rbenamotz/LEMPA/imgs/2D_V4.png

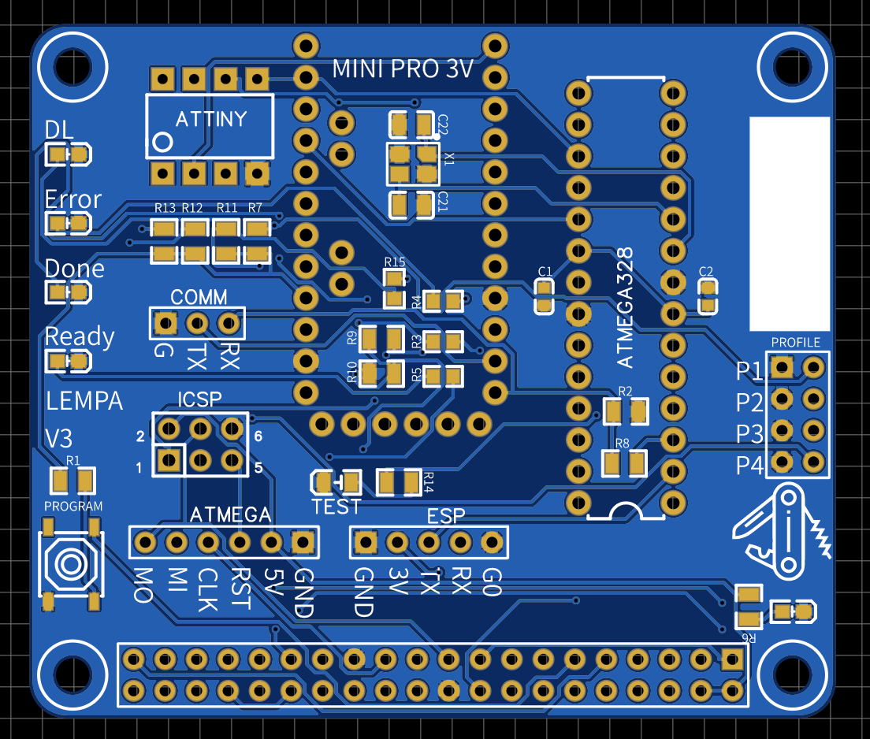
imgs/2D_V4.png
