rbenamotz/LEMPA/imgs/3D.png

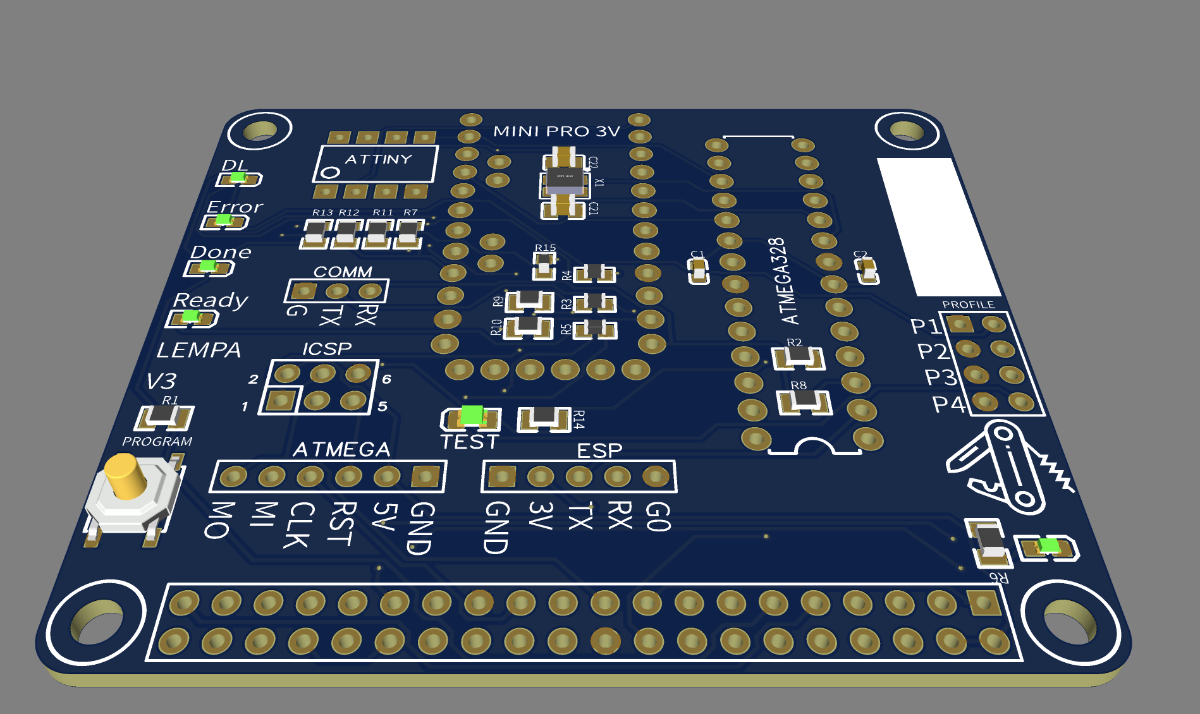
imgs/3D.png
