rbenamotz/LEMPA/imgs/arduino ide.png

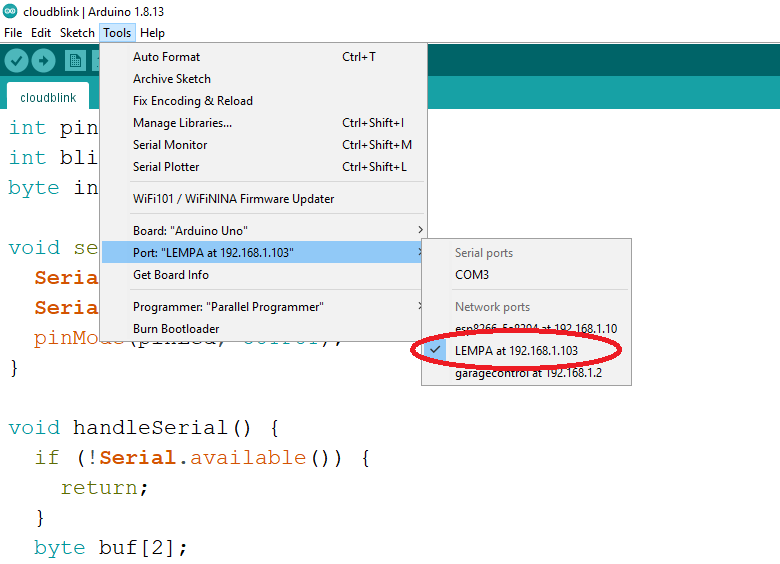
imgs/arduino ide.png
