rbenamotz/LEMPA/imgs/v41_2d.jpg

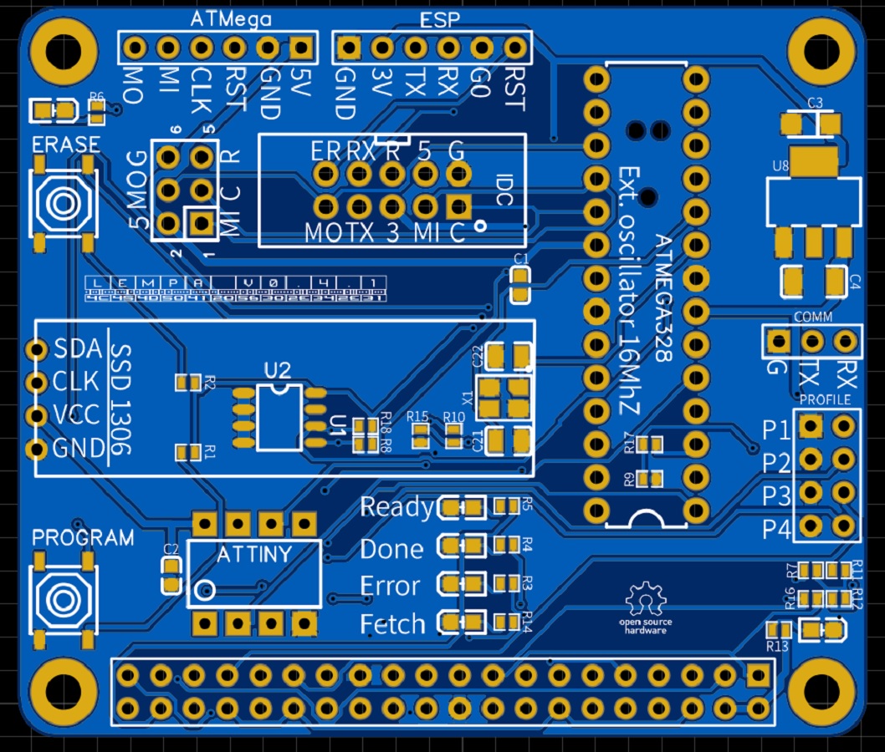
imgs/v41_2d.jpg
