rbenamotz/LEMPA/imgs/v41_4.jpg

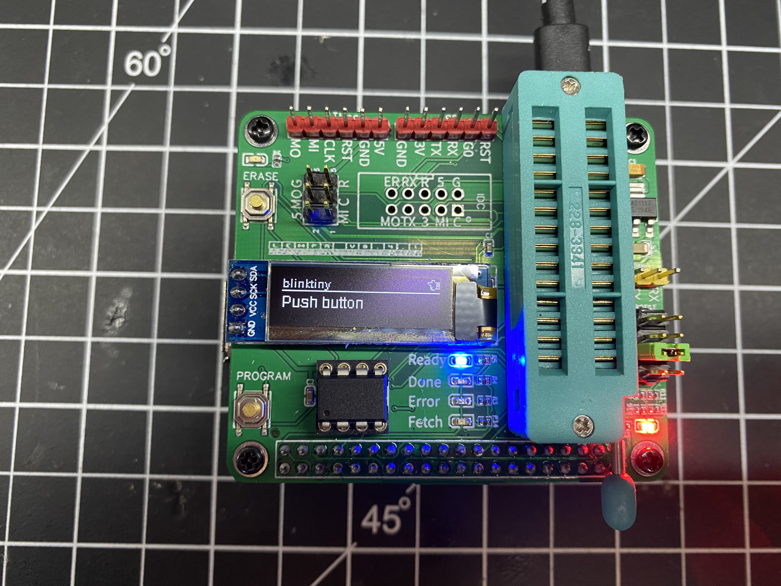
imgs/v41_4.jpg
