rbenamotz/LEMPA/imgs/v41_schematic.jpg

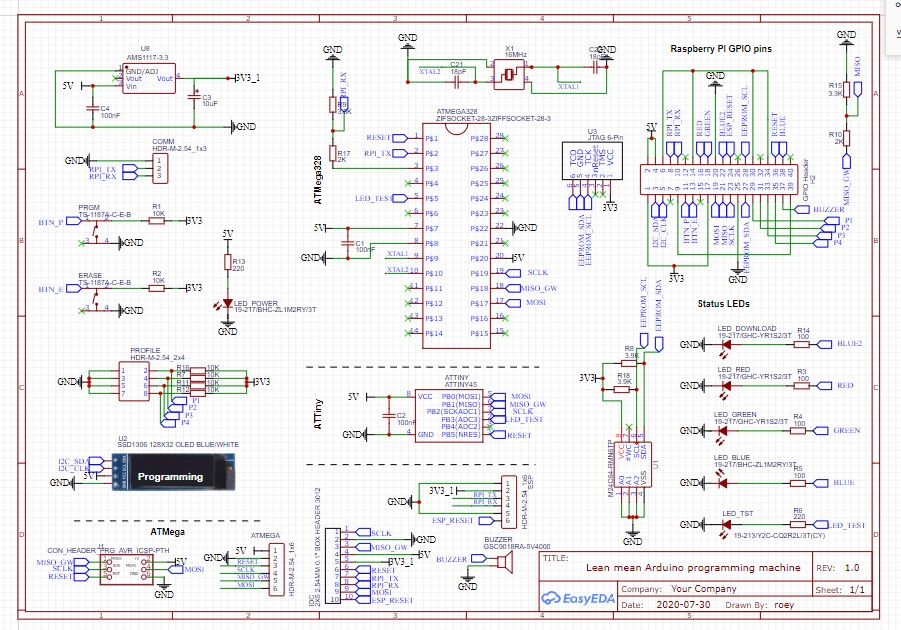
imgs/v41_schematic.jpg
