rbenamotz/LEMPA/imgs/yt.png

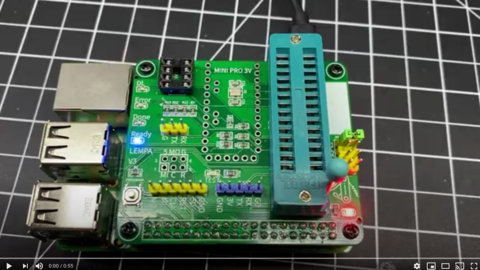
imgs/yt.png
