rbenamotz/LEMPA/(threads)

Thread 2 (2020-09-06):

Feature request: support for TI Spyi-Bi-Wire

codehero, 2020-09-06:
This would be useful for programming single or multiple MSP430 units.

rbenamotz, 2020-09-06:
I don't have access to such a board at the moment but will keep that as future issue. Thanks!

codehero, 2020-09-07:
I will order you an MSP430 launchpad if you want. The way the jumpers work you can select between the onboard programmer and your RPI gpio. I am sure the mspdebug folks would be happy to help out.

rbenamotz, 2020-09-07:
Can you contact me at roey@benamotz.com ?

Thread 3 (2020-09-06):

PCB Schematic?

mtfurlan, 2020-09-06:
I can't seem to find the actual schematic for the PCB?

I've been working on a kinda similar thing, designed around a USB<-->UART FT232 instead of a pi, and I'm curious how you're dealing with GPIO0 and 3V3 on the ESP to rest it properly and such things.
I've been planning to use the reset circuit off the D1 mini, but I'm curious as to how you approached it.

rbenamotz, 2020-09-06:
Hi

You can find the schematics here:

https://easyeda.com/roey/flower-tzarvan_copy

I am taking a very simple approach toward ESP (but it works): One of the pins is for GPIO0 and it's always grounded so once you connect the ESP, it's on program mode. Once programming is done you unplug the ESP.
On future version I am adding option for reset.

Another issue I approacheed with ESP was the fact that in many boards I have ATMega32 + ESP on the same board connected via serial. When that happens I cannot program the ESP as the ATMega keeps the TX pin HIGH all the time. The solution I used is the following:
1. I created a very small ATMega firmware which just disables the TX `(_SFR_BYTE(UCSRB) &= ~_BV(TXEN));`
2. Added a script capbility to the programmer (composite in the JSON)
3. The programmer, on single click, does the follwing: 1. Load the dummy firmware to ATMega 2. Loads the ESP (as its serial is free now) 3. Loads the real firmware to the ATMega

Hope this helps

Roey

mtfurlan, 2020-09-06:
Oh, that makes sense.
Thank you!

Closed 2020-09-06.

Thread 10 (2020-10-04):

Button won't response if down before state loads

rbenamotz, 2020-10-04:
**Describe the bug**
Button won't response if down before state loads

**To Reproduce**
Steps to reproduce the behavior:
1. Push prog button
2. Start LEMPA (don't let go of the button)
3. Release the button only when it enters the "wait for button" state

**Expected behavior**
Clicking on a prog button will.. prog but it does not respond

rbenamotz, 2020-10-04:
fixed (and anyway it was created to test the github comments mechanism)

Closed 2020-10-04.

Thread 20 (2020-10-30):

Remote I/O error

rbenamotz, 2020-10-30:
[Errno 121] Remote I/O error
Traceback (most recent call last):
  File "./program.py", line 54, in <module>
    cycle()
  File "./program.py", line 41, in cycle
    event = state.do_step()
  File "/home/pi/LEMPA/states/wait_for_button_state.py", line 39, in do_step
    if self.button_erase.loop() or self.button_prog.loop():
  File "/home/pi/LEMPA/states/hat_button.py", line 68, in loop
    return self.__check_long_click()
  File "/home/pi/LEMPA/states/hat_button.py", line 43, in __check_long_click
    self.app.print(self.long_click_action_name + "? " + str(pt))
  File "/home/pi/LEMPA/application.py", line 58, in print
    v.print(txt)
  File "/home/pi/LEMPA/views/display_view.py", line 88, in print
    self.__refresh()
  File "/home/pi/LEMPA/views/display_view.py", line 78, in __refresh
    self.disp.display()
  File "/home/pi/.local/lib/python3.7/site-packages/Adafruit_SSD1306/SSD1306.py", line 182, in display
    self._i2c.writeList(control, self._buffer[i:i+16])
  File "/home/pi/.local/lib/python3.7/site-packages/Adafruit_GPIO/I2C.py", line 127, in writeList
    self._bus.write_i2c_block_data(self._address, register, data)
  File "/home/pi/.local/lib/python3.7/site-packages/Adafruit_PureIO/smbus.py", line 364, in write_i2c_block_data
    self._device.write(data)
OSError: [Errno 121] Remote I/O error

                              Exception
Traceback (most recent call last):
  File "./program.py", line 54, in <module>
    cycle()
  File "./program.py", line 41, in cycle
    event = state.do_step()
  File "/home/pi/LEMPA/states/wait_for_button_state.py", line 39, in do_step
    if self.button_erase.loop() or self.button_prog.loop():
  File "/home/pi/LEMPA/states/hat_button.py", line 68, in loop
    return self.__check_long_click()
  File "/home/pi/LEMPA/states/hat_button.py", line 43, in __check_long_click
    self.app.print(self.long_click_action_name + "? " + str(pt))
  File "/home/pi/LEMPA/application.py", line 58, in print
    v.print(txt)
  File "/home/pi/LEMPA/views/display_view.py", line 88, in print
    self.__refresh()
  File "/home/pi/LEMPA/views/display_view.py", line 78, in __refresh
    self.disp.display()
  File "/home/pi/.local/lib/python3.7/site-packages/Adafruit_SSD1306/SSD1306.py", line 182, in display
    self._i2c.writeList(control, self._buffer[i:i+16])
  File "/home/pi/.local/lib/python3.7/site-packages/Adafruit_GPIO/I2C.py", line 127, in writeList
    self._bus.write_i2c_block_data(self._address, register, data)
  File "/home/pi/.local/lib/python3.7/site-packages/Adafruit_PureIO/smbus.py", line 364, in write_i2c_block_data
    self._device.write(data)
OSError: [Errno 121] Remote I/O error

During handling of the above exception, another exception occurred:

Traceback (most recent call last):
  File "./program.py", line 62, in <module>
    state = load_state(Application.APP_STATE_EXCEPTION)
  File "./program.py", line 31, in load_state
    app.app_state = code
  File "/home/pi/LEMPA/application.py", line 92, in app_state
    v.header()
  File "/home/pi/LEMPA/views/display_view.py", line 98, in header
    self.__refresh()
  File "/home/pi/LEMPA/views/display_view.py", line 78, in __refresh
    self.disp.display()
  File "/home/pi/.local/lib/python3.7/site-packages/Adafruit_SSD1306/SSD1306.py", line 168, in display
    self.command(0)              # Column start address. (0 = reset)
  File "/home/pi/.local/lib/python3.7/site-packages/Adafruit_SSD1306/SSD1306.py", line 129, in command
    self._i2c.write8(control, c)
  File "/home/pi/.local/lib/python3.7/site-packages/Adafruit_GPIO/I2C.py", line 114, in write8
    self._bus.write_byte_data(self._address, register, value)
  File "/home/pi/.local/lib/python3.7/site-packages/Adafruit_PureIO/smbus.py", line 322, in write_byte_data
    self._device.write(data)
OSError: [Errno 121] Remote I/O error

Closed 2021-03-13.
