rbenamotz/LEMPA/hardware.py

# buttons
PIN_BUTTON_PROG = 17
PIN_BUTTON_ERASE = 27

# LEDs
PIN_RED = 23
PIN_GREEN = 24
PIN_BLUE = 20
PIN_BLUE2 = 25

# Jumpers
PINS_PROFILES = [5, 6, 13, 19]

# MCU
PIN_RESET_ATMEGA = 16
PIN_MASTER_POWER = 12
PIN_ESP_RESET = 8
PIN_ESP_GPIO_0 = 4

# MISC
PIN_BUZZER = 26

# Interfaces
DEFAULT_SERIAL_SPEED = 9600
DEFAULT_PRGM_COMM_SPEED = 115200
SERIAL_PORT = "/dev/serial0"
