rbenamotz/LEMPA/states/sense_profile_state.py

import sys
import time

import RPi.GPIO as GPIO

from application import Application, COMMAND_LINE_PARAM_PROFILE_ID
from profiles import profile_by_id, profile_by_jumper
from . import State
from hardware import PINS_PROFILES


class SensingProfileState(State):
    def __load_profile__(self, profile_id, first=True):
        p = profile_by_id(profile_id)
        if first:
            self.app.profiles = []
            self.app.profile_name = profile_id
            self.app.profile_info = p
            self.app.detail('Loading "{}"'.format(profile_id))
            if "plugins" in p:
                for pl in self.app.plugins:
                    pl.load_conf(p["plugins"][0]["conf"])
        if p["type"] == "bin":
            self.app.profiles.append(p)
            return True
        if p["type"] == "composite":
            for p0 in p["profiles"]:
                self.__load_profile__(p0, False)
            return True
        raise ValueError("Unknown profile type {}".format(p["type"]))

    def __init__(self, app):
        super().__init__(app)
        for p in PINS_PROFILES:
            GPIO.setup(p, GPIO.IN, pull_up_down=GPIO.PUD_UP)
        self.app.skip_detect = False
        if len(sys.argv) >= COMMAND_LINE_PARAM_PROFILE_ID + 1:
            profile_id = sys.argv[COMMAND_LINE_PARAM_PROFILE_ID]
            if not profile_id == "_":
                self.app.detail("Using profile from args: {}".format(profile_id))
                self.__load_profile__(sys.argv[1])
                self.app.skip_detect = True
                return
        self.app.detail("Detecting profile by jumper")
        self.message_shown = False

    def do_step(self):
        if self.app.skip_detect:
            return True
        for j in range(4):
            p = PINS_PROFILES[j]
            if not GPIO.input(p):
                self.app.detail("Detected jumper {}".format(j + 1))
                temp = profile_by_jumper(j + 1)
                profile_id = temp["id"]
                self.__load_profile__(profile_id)
                return True
        time.sleep(0.1)
        if not self.message_shown:
            self.app.print("Connect jumper")
            self.message_shown = True
        return False

    def on_event(self, event):
        if event:
            return Application.APP_STATE_FIRMWARE_DOWNLOAD
        return self
