rbenamotz/LEMPA/states/fail_state.py

import time

from application import Application
from states import State


class FailState(State):
    def __init__(self, app):
        super().__init__(app)

    def on_event(self, event):
        return Application.APP_STATE_WAITING_FOR_BUTTON

    def do_step(self):
        time.sleep(3)
        return True
