rbenamotz/LEMPA/(commit log)

2020-08-11 Workaround to load external profiles and specific id
    [profiles.py, sense_profile_state.py]
2020-08-24 Fixed download LED
2020-09-05 Added Tindie button
2020-09-20 Initial support for erase button
2020-09-29 Scrolling diplay bug fix
    [display_view.py]
2020-10-04 [#10] Fixes issue with button
    [hat_button.py]
2020-10-25 Bug fix of HAT info parsing
    [env_init_state.py]
2021-01-25 bug fix: serial collision between serial monitor and ESP programmer
    [SerialConnectionThread.py, env_init_state.py, esp.py]
2021-08-30 web: program button
2021-08-31 bug fix: app might be null on view
    [terminal_view.py]
