rbenamotz/LEMPA/imgs/4v1_1.jpeg

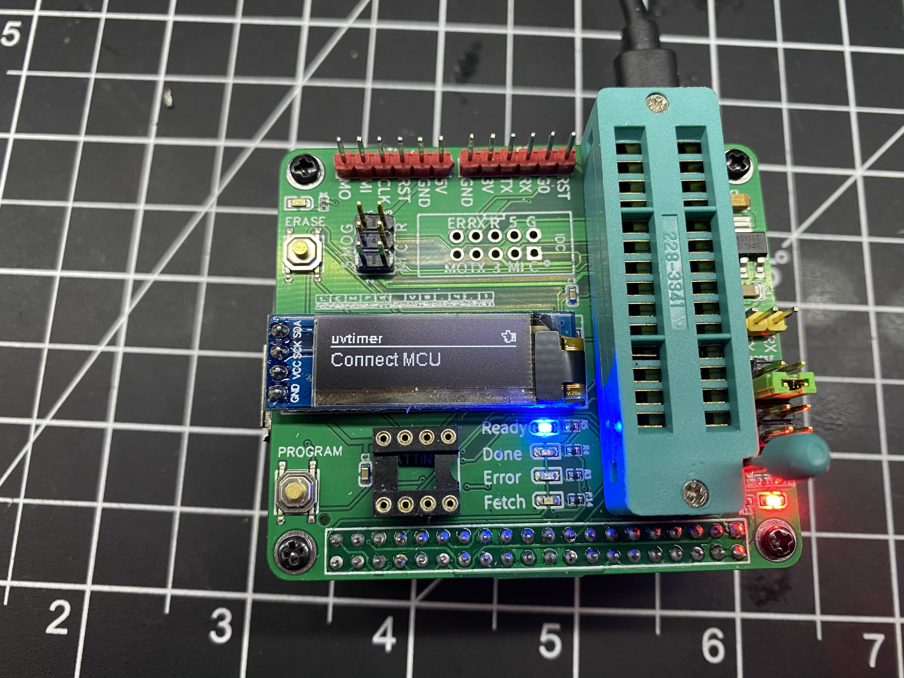
imgs/4v1_1.jpeg
