rbenamotz/LEMPA/imgs/v41_2.jpeg

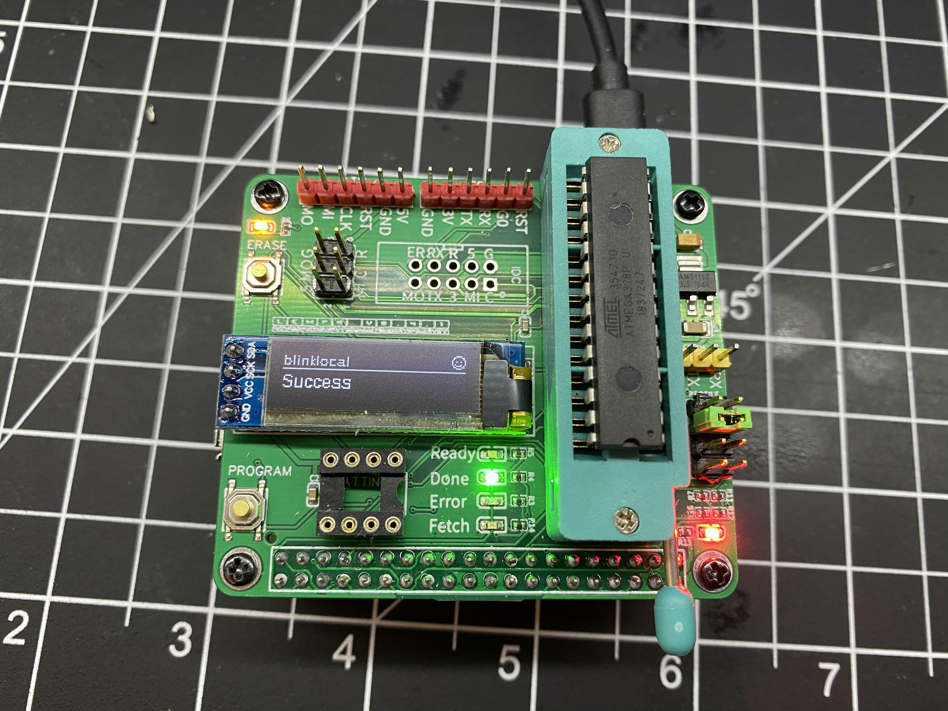
imgs/v41_2.jpeg
