rbenamotz/LEMPA/imgs/v41_3.jpeg

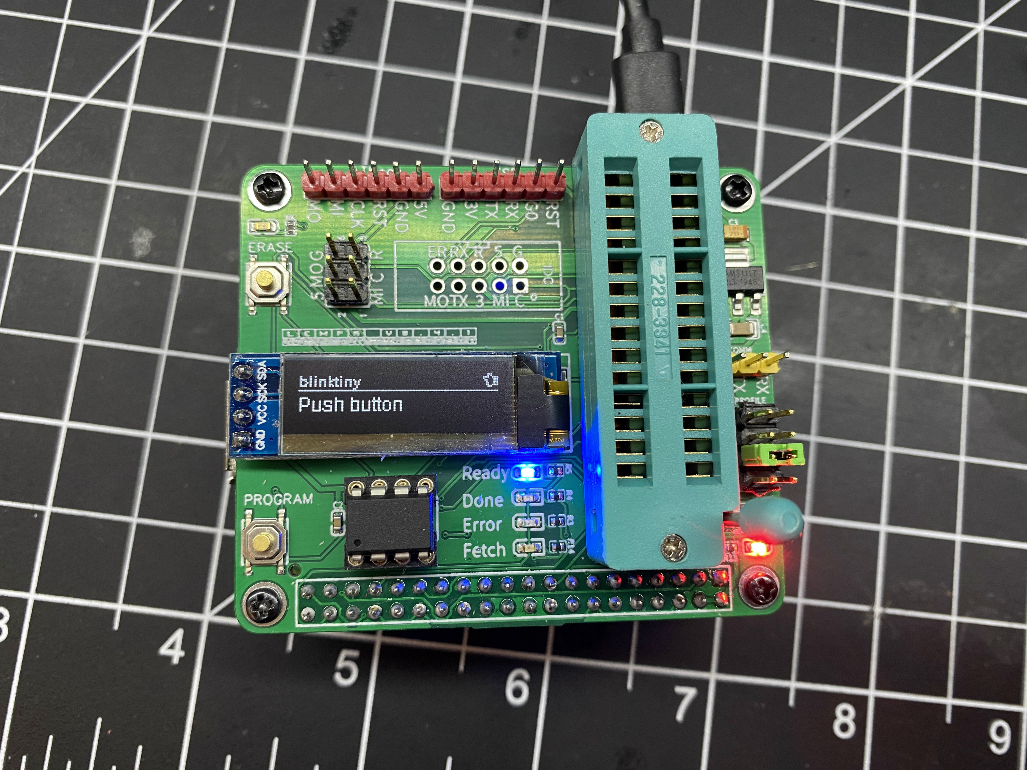
imgs/v41_3.jpeg
